r3vert/KanaType/Firmware/mockups/bold_loop_check.png

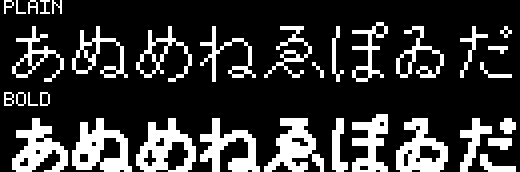
Firmware/mockups/bold_loop_check.png
