r3vert/KanaType/Firmware/mockups/drill_new.png

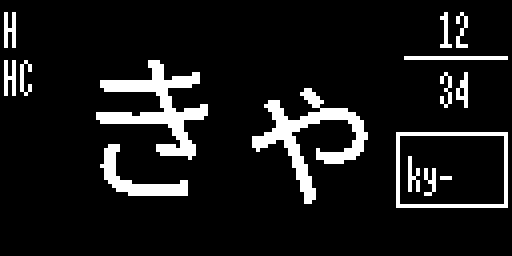
Firmware/mockups/drill_new.png
