r3vert/KanaType/Firmware/mockups/drill_real.png

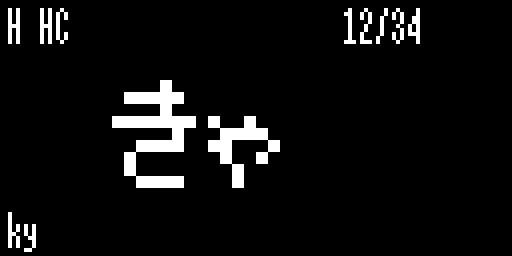
Firmware/mockups/drill_real.png
