r3vert/KanaType/Firmware/mockups/drill_reflow.png

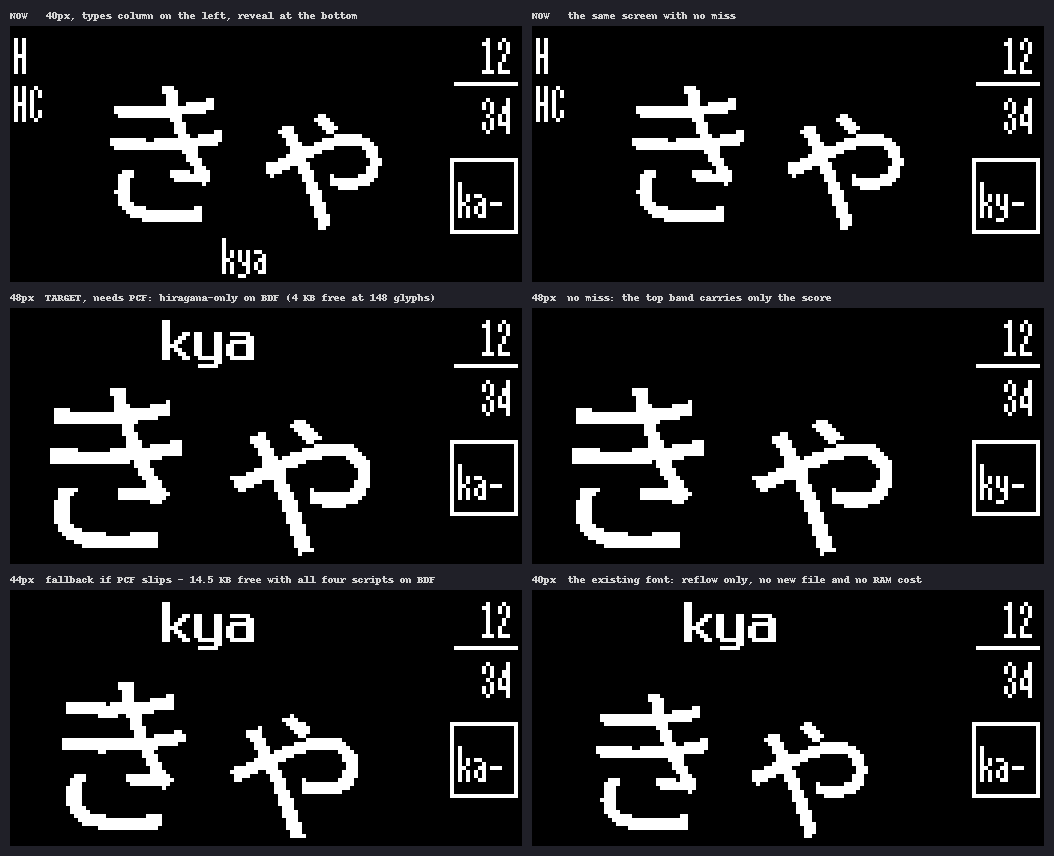
Firmware/mockups/drill_reflow.png
