r3vert/KanaType/Firmware/mockups/drill_reflow_cases.png

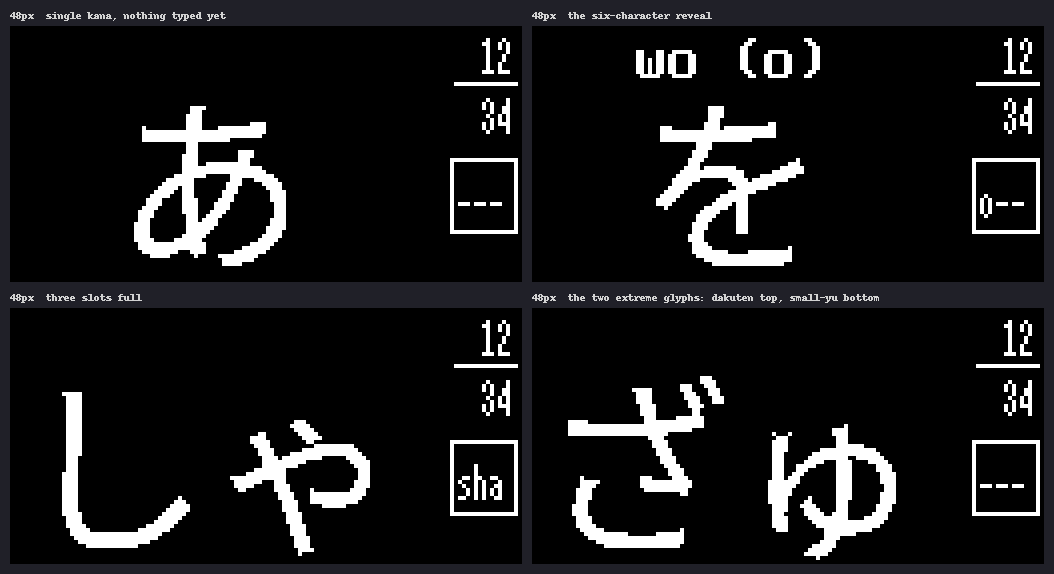
Firmware/mockups/drill_reflow_cases.png
