r3vert/KanaType/Firmware/mockups/drill_states.png

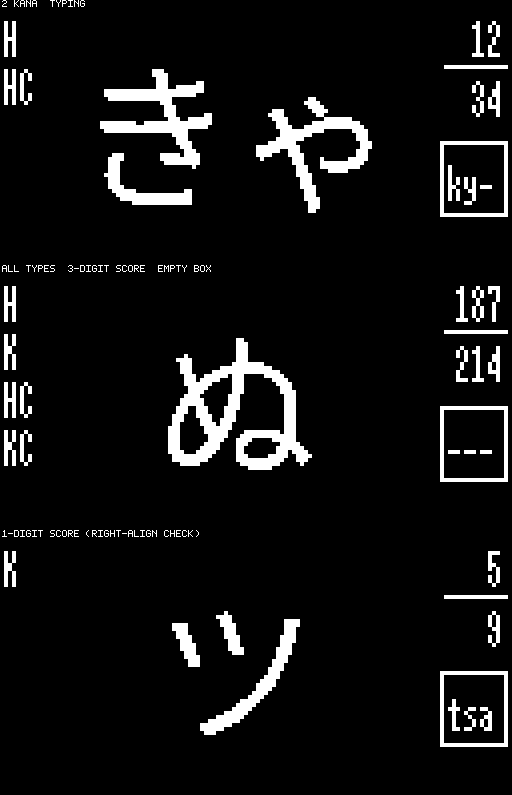
Firmware/mockups/drill_states.png
