r3vert/KanaType/Firmware/mockups/font_picker.png

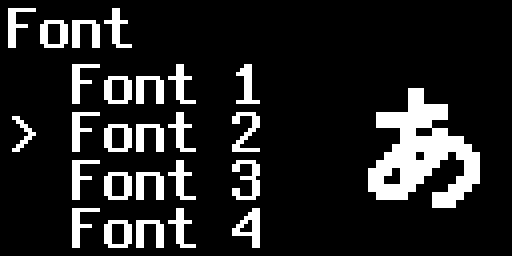
Firmware/mockups/font_picker.png
