r3vert/KanaType/Firmware/mockups/keyboard_status.png

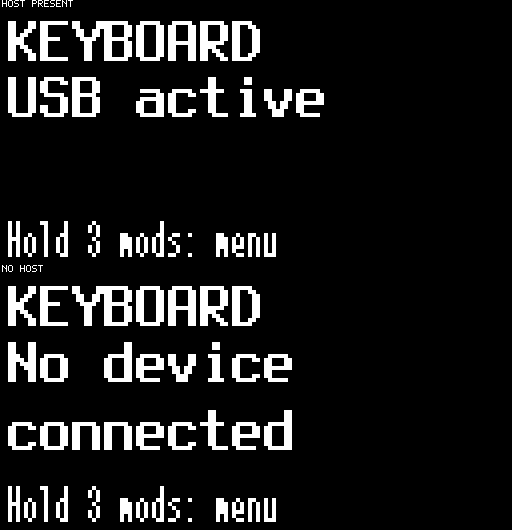
Firmware/mockups/keyboard_status.png
