r3vert/KanaType/Firmware/mockups/keymap_diagram.png

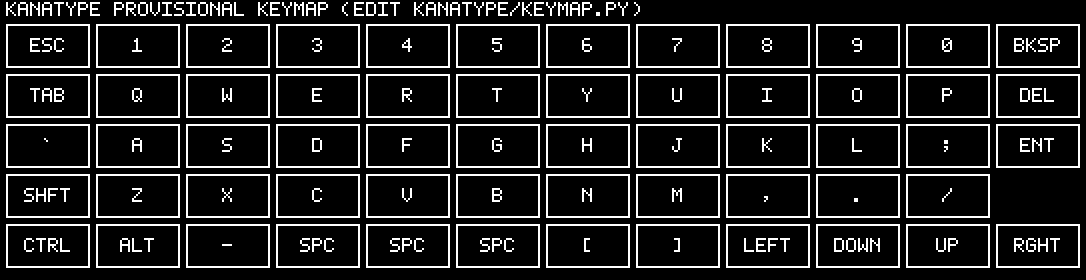
Firmware/mockups/keymap_diagram.png
