r3vert/KanaType/Firmware/mockups/loading_real.png

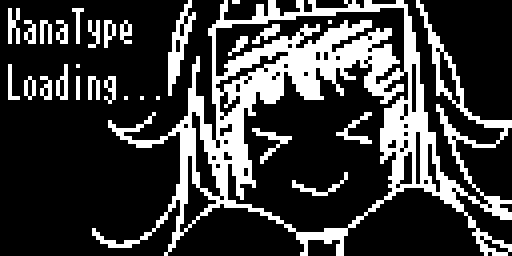
Firmware/mockups/loading_real.png
