r3vert/KanaType/Firmware/mockups/menu_16_vs_14.png

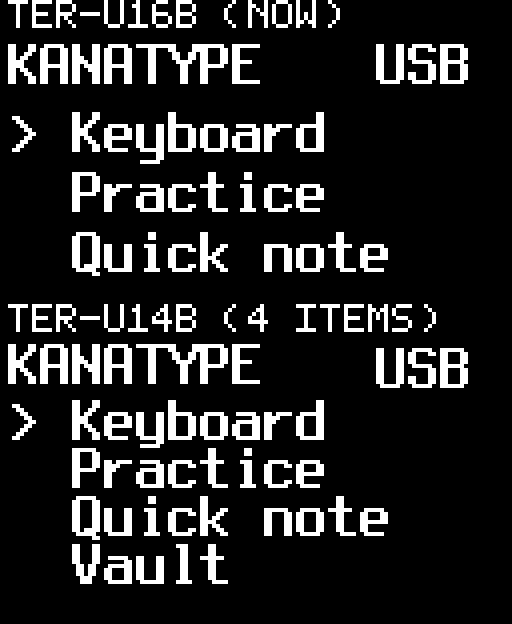
Firmware/mockups/menu_16_vs_14.png
