r3vert/KanaType/Firmware/mockups/menu_real.png

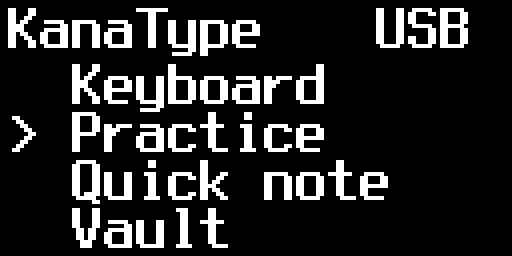
Firmware/mockups/menu_real.png
