r3vert/KanaType/Firmware/mockups/menu_terminus.png

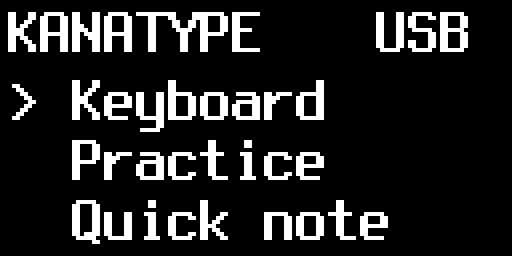
Firmware/mockups/menu_terminus.png
