r3vert/KanaType/Firmware/mockups/menu_x4.png

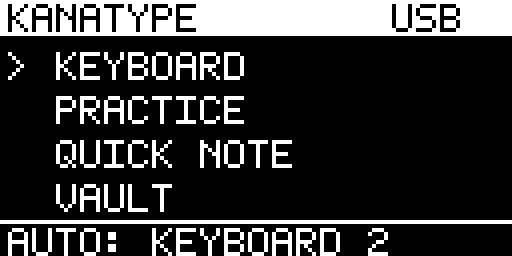
Firmware/mockups/menu_x4.png
