r3vert/KanaType/Firmware/mockups/practice_groups.png

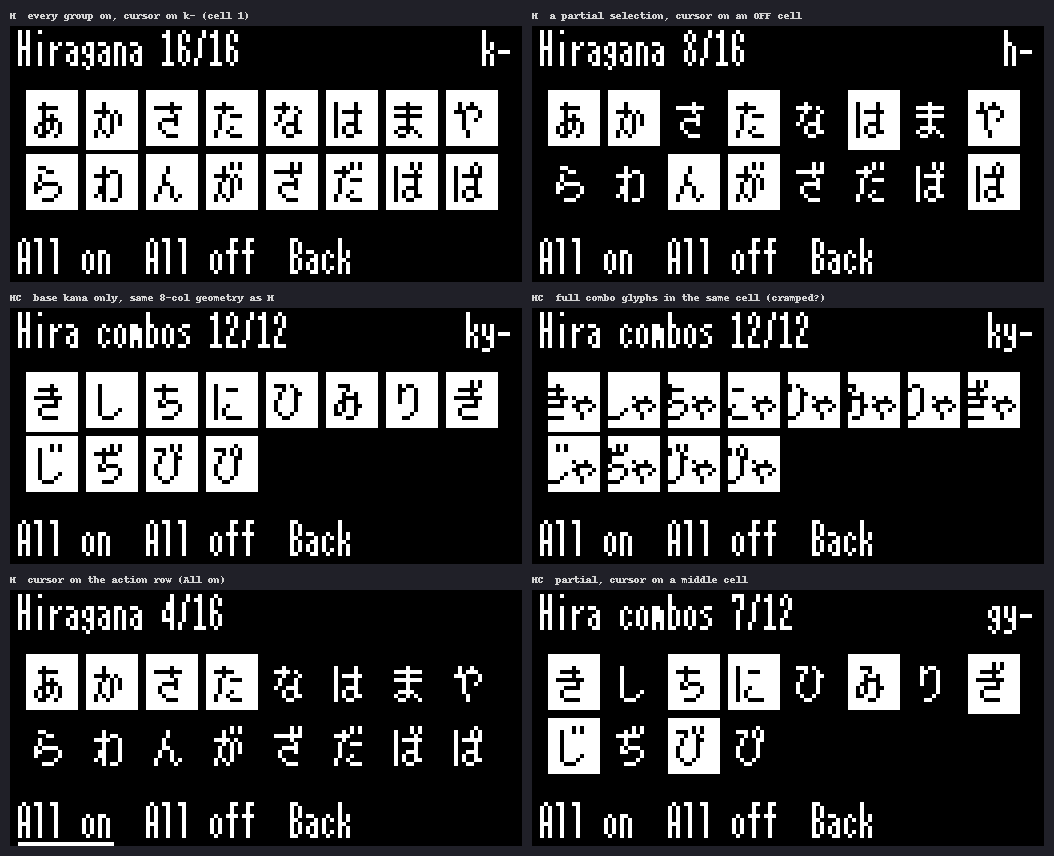
Firmware/mockups/practice_groups.png
