r3vert/KanaType/Firmware/mockups/practice_stats.png

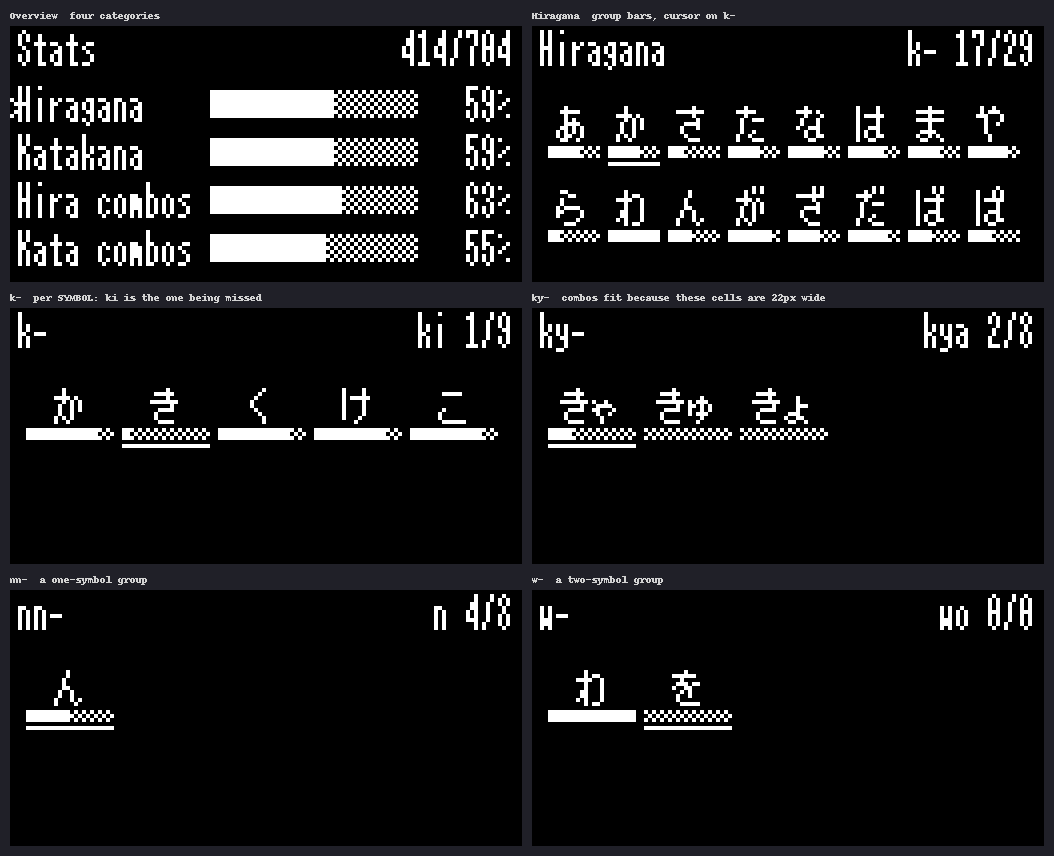
Firmware/mockups/practice_stats.png
