r3vert/KanaType/Firmware/mockups/prompt_3way.png

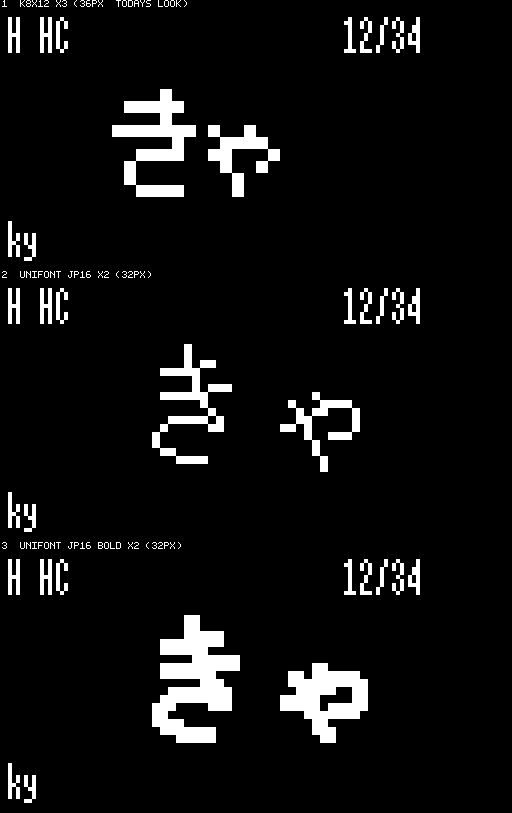
Firmware/mockups/prompt_3way.png
