r3vert/KanaType/Firmware/mockups/prompt_12_vs_16.png

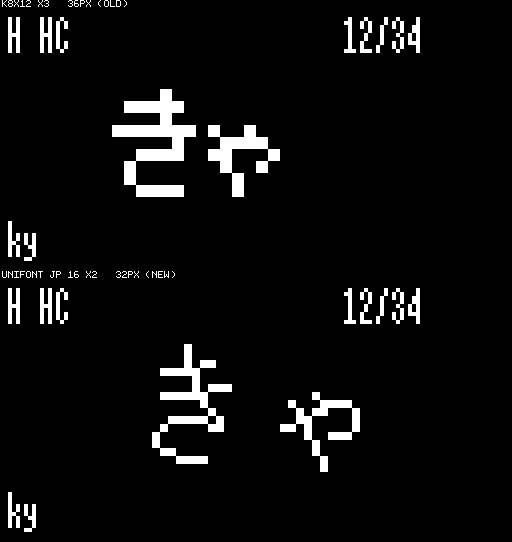
Firmware/mockups/prompt_12_vs_16.png
