r3vert/KanaType/Firmware/mockups/prompt_48_mock.png

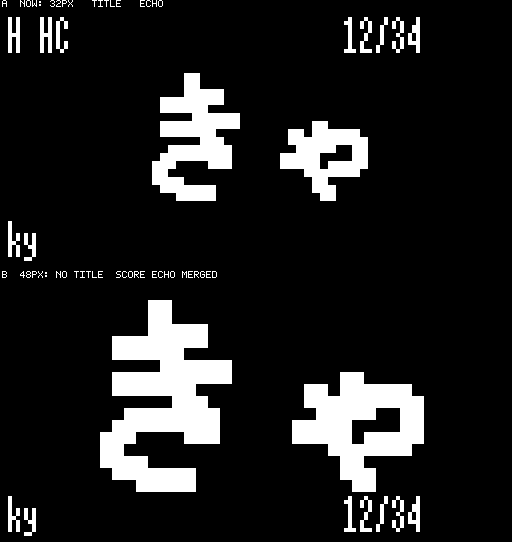
Firmware/mockups/prompt_48_mock.png
