r3vert/KanaType/Firmware/mockups/prompt_48_sources.png

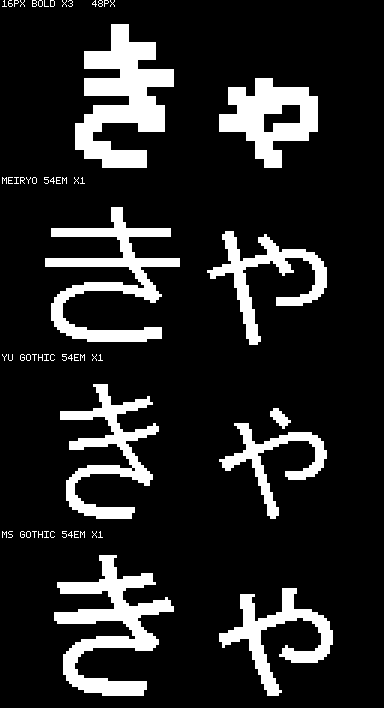
Firmware/mockups/prompt_48_sources.png
