r3vert/KanaType/Firmware/mockups/welcome (1).bmp

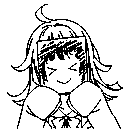
Firmware/mockups/welcome (1).bmp
