r3vert/KanaType/Firmware/mockups/welcome_BD.png

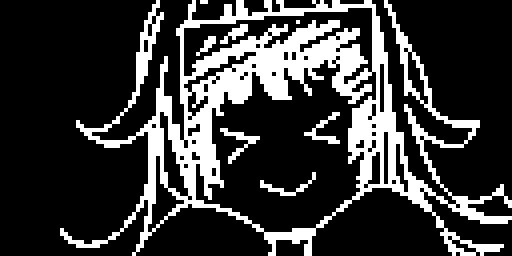
Firmware/mockups/welcome_BD.png
