r3vert/KanaType/Firmware/mockups/welcome_variants.png

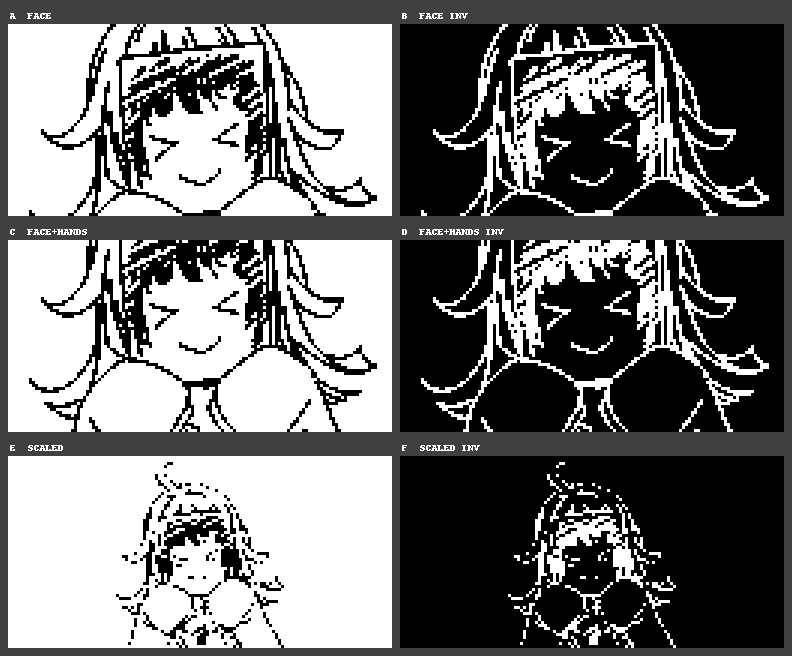
Firmware/mockups/welcome_variants.png
