r3vert/KanaType/Firmware/x.png

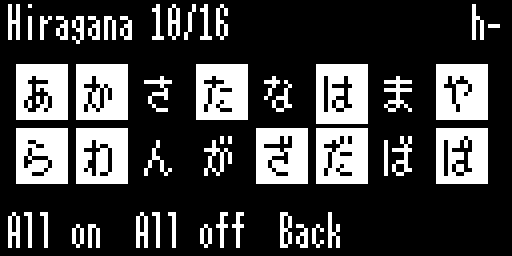
Firmware/x.png
