r3vert/KanaType/3D Printing/Bottom Case.3mf

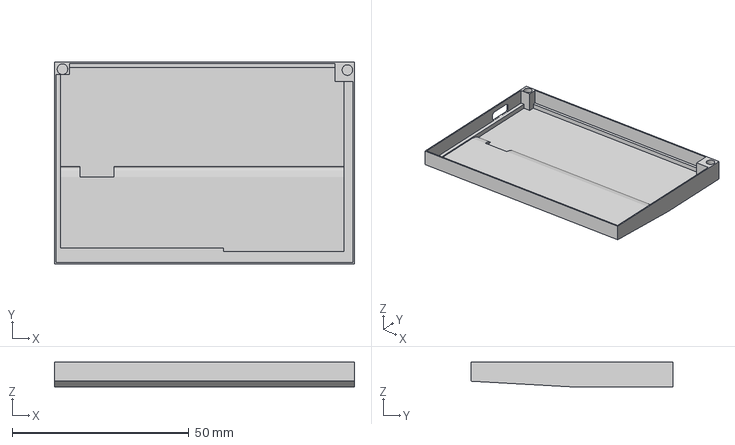
[picture p25: CAD file, 2026-08-28]
3D Printing/Bottom Case.3mf
84.8 x 57.0 x 7.00 mm
