r3vert/KanaType/3dmodels/SW-SMD_4P-L4.2-W3.2-P2.15-LS4.6.step

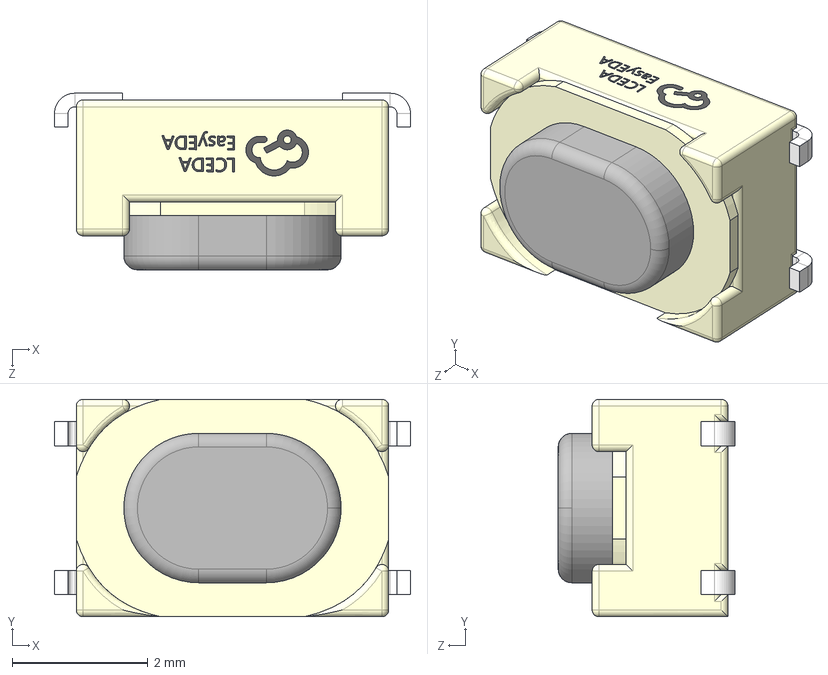
[picture p26: CAD file, 2026-07-29]
3dmodels/SW-SMD_4P-L4.2-W3.2-P2.15-LS4.6.step
5.24 x 3.20 x 2.60 mm
