r3vert/KanaType/KanaType.step

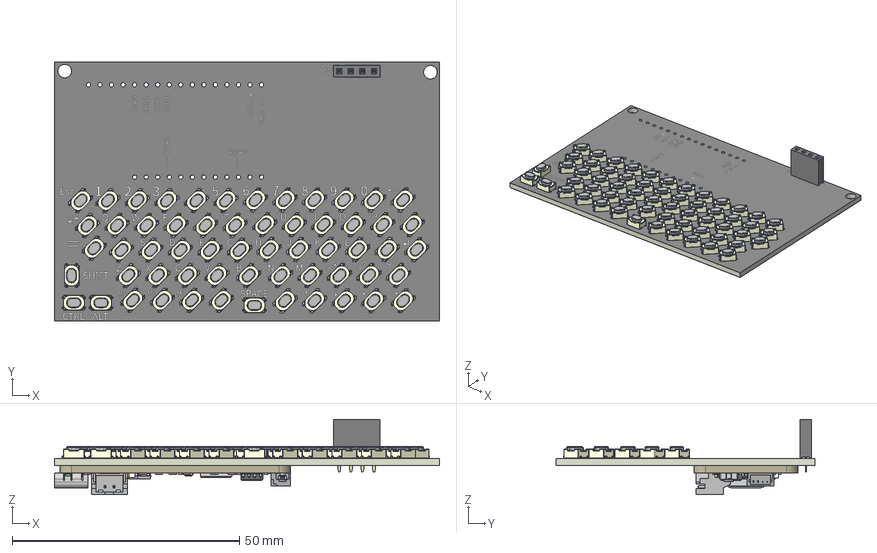
[picture p27: CAD file, 2026-08-03]
KanaType.step
84.8 x 57.0 x 16.6 mm
SW-SMD_4P-L4.2-W3.2-P2.15-LS4.6 x 59
PinSocket_1x04_P2.54mm_Vertical
Board
0805-NO x 4
CHIPLED_0603_NOOUTLINE x 2
0603-NO x 26
BTN_KMR2_4.6X2.8 x 2
SOT23-5@1
JSTPH2_BATT
SOT23-5
LED3535
SOIC8_208MIL
SOD-123
SOT23-R
USB_C_CUSB31-CFM2AX-01-X
QFN56_7MM_REDUCEDEPAD
JST_SH4
CRYSTAL_2.5X2
KanaType_silkscreen x 2
KanaType_soldermask x 2
KanaType_PCB
