r3vert/KanaType/Firmware/BRINGUP.md

# Bring-up checklist — first deploy after the 2026-08 changes

This deploy is unusually large: fonts were replaced, the practice screen was
reflowed, two apps are new, and several screens changed how they refresh. Work
top to bottom; each task says what "good" looks like and what to do if it isn't.

Tick boxes as you go. If something fails, note *what you saw* — that is what
makes it fixable.

---

## STATUS (updated live)

Last updated 2026-08-30. Clock done; the accuracy fix is confirmed on hardware.

**Committed AND pushed**: `master` is at `07276c4` on
github.com/r3vert/KanaType, ten commits, working tree clean. A pre-publish
audit removed the Windows username from 61 PCB 3D-model paths, the board UID
from `OLD/boot_out.txt`, and the 4 MB `fp-info-cache`; Terminus and Unifont
licenses were added and preflight now enforces that every `.bdf` has one.

**Tasks 1-5 and 8 are DONE on hardware.** Confirmed working: the launcher home
screen, the keyboard app with macros/profiles/second layer, and Practice
(config persistence, font picker, correction mode, relocated hint, reset to
defaults, atomic multi-kana prompts, the one-time glyph preload). RAM measured:
48 320 B free with hiragana, 24 304 B with all four scripts = 312 B per 40px
glyph, which closes PLAN open item #2.

**Tasks 6 and 7 are DONE.** WAKE brings the device back and ordinary keys do
not; the Clock sets, commits and survives leaving the app.

**Task 8 is DONE** (2026-08-30). The accuracy fix is confirmed on hardware in
both directions: set the clock and press RESET, and Clock comes back with the
frozen time flagged `approx (slept)`; sleep and wake on USB and it stays exact.
Background on why the flag never appeared in the first hardware test; two
causes, both since fixed:

* accuracy was decided when the stamp was WRITTEN, not when it was RESTORED.
  A plain RESET therefore restored a stale time and presented it as exact,
  while a USB fake-sleep (RTC still ticking, time genuinely exact) would have
  flagged it approximate. `restore_time_after_sleep()` now sets the flag,
  because a deep sleep, a RESET and a flat battery are indistinguishable from
  up there; preflight walks all four boot cases.
* **`RTC UNSET!` hides `approx`.** With the clock never set, the stamp carries
  a pre-2024 year, and `apps/clock.py` shows the unset warning in preference
  to the approximate one. Until the clock is set by hand, the flag cannot
  appear in the Clock app no matter what nvm holds -- only Home's `~` shows.

**Next action is task 9 (battery-only pass).** Also untested: the Mac handoff
(task 10).

**M2 is unblocked and PCF is in progress** -- PCF stopped being a boot-speed
nice-to-have when the drill reflow targeted a 48 px prompt (PLAN.md backlog 3).

The only thing left in task 5 is sighting `wo (o)`, which just needs that kana
to come up.

If the drive goes read-only again (it has, repeatedly), run in an **elevated**
PowerShell. `deploy.ps1` now probes writability first and prints this command
itself — before the fix it printed "Deployed" while copying nothing, because
robocopy exits 2 (not >= 8) on a write-protected target:

```powershell
Get-Volume | Where-Object FileSystemLabel -eq CIRCUITPY | Get-Partition | ForEach-Object { Set-Disk -Number $_.DiskNumber -IsReadOnly $false }
```

## 1. Delete the stale fonts  ✅ DONE

The deploy scripts are non-destructive on purpose (`robocopy /E`, `rsync`
without `--delete`) so device-side `lib/` installs are never clobbered. The
downside: fonts removed from the repo stay on the device forever.

- [x] Plug in the device, confirm CIRCUITPY mounts
- [x] Delete from `CIRCUITPY/fonts/`:
  - `k8x12.bdf` (845 KB) — replaced by `k8x12_kana.bdf`
  - `misaki_gothic.bdf` (764 KB) — role retired
  - `LICENSE-misaki.txt` (optional tidiness)
- [x] Confirm ~1.6 MB of free space came back

**Good:** `fonts/` holds only the files that are in `Firmware/src/fonts/`.

---

## 2. Preflight, then deploy  ✅ DONE

- [x] `python Firmware/tools/preflight.py` → **PREFLIGHT PASSED**
      (with the device plugged in it also flags any stale font it still finds)
- [x] `.\Firmware\tools\deploy.ps1`   (Windows)
      or `./Firmware/tools/deploy.sh`  (macOS/Linux)
- [x] Device auto-reloads

**If preflight fails:** stop. It only reports problems that have actually
broken this project before; deploying past it wastes a debugging cycle.

---

## 3. Boot and launcher  ✅ DONE (all 4 confirmed)

- [x] Panel goes straight from black to the menu — **no REPL / "Ctrl-D" text**
- [x] Title reads `KanaType`, six entries: Keyboard, Practice, Quick note,
      Vault, Clock, Sleep
- [x] Top-right shows a **tilde** briefly, then a **lightning bolt** (USB)
- [x] Arrow keys / `j`,`k` scroll the menu; it feels immediate, not laggy
- [x] Cursor starts on **Keyboard** (because USB is present)

**Then test the polling fix:**

- [x] Sit at the menu, unplug USB → icon changes to **battery** within ~1 s
- [x] Plug back in → icon returns to **bolt**, and the cursor does **not** jump

**If the icon never changes:** the poll isn't running — capture whether it was
stuck on bolt or battery.

---

## 3b. Boot timing measurement  ✅ DONE

    before:  display 180ms  input 271ms  menu 4648ms
    after:   display 180ms  input 270ms  menu  827ms
             [font 64  glyphs 595  labels 95  icons 19  paint 51]

The line reprints every 3 s while the menu is idle, since PuTTY can only attach
after boot. Toggle is `DEBUG_BOOT_TIMING` at the top of `src/code.py`; set it
`False` when you no longer want the noise. Repeats carry `(uptime Ns)`.

**Cause was not font size or `.mpy`** - the BDF loader has no glyph index, so
every uncached character rescans the whole `.bdf` from byte 0, and the menu
build did ~6 of them. `ui.preload()` now does one pass up front: 5.5x faster.
Full write-up and the per-font scan costs are in `PLAN.md`.

Boot is now ~1.3 s to an interactive menu, with the splash on screen from
180 ms, so the black screen is no longer the problem. The remaining 595 ms is
one honest pass over the BDF - see the PCF option in PLAN.md.

The same rescan hit the drill prompt at ~3.1 s per first-seen kana; `drill.py`
now preloads each font in one pass at start instead. PCF is the logged
follow-up that removes scanning altogether (PLAN.md).

## 4. Keyboard app + macro system  ✅ DONE

The whole app was rewritten on 2026-08-28 and has never run on hardware in this
form. Work it in order; the later checks assume the earlier ones passed.

### 4a. Base typing

- [x] Open Keyboard. Screen shows `KEYBOARD`, a bolt icon, `1234567890` over
      `!@#$%^&*()` on the left, `M1..M4` with assignments on the right, and
      `tap: setup` / `hold: exit` bottom-left
- [x] Type in a text editor — letters match the printed keys
- [x] `Shift`+letter capitalises; `Ctrl`+C/V copy-paste; `Alt` behaves
- [x] Spacebar (SW57, the key with the SPACE legend) types a space
- [x] Arrow keys move the caret in the right directions
- [x] **M1 types `-`** (the board's only hyphen), M2 `Ctrl+C`, M3 `Ctrl+V`,
      M4 `Ctrl+Shift+V` — M4 is the UNLABELLED key between M3 and the spacebar
- [x] The key right of the spacebar no longer types `]`

### 4b. MENU tap vs hold

- [x] Tap MENU (under Tab) → setup overlay, titled `SETUP M1-M4`
- [x] **While the overlay is open, typing does NOT reach the PC.** Watch the
      editor: every key should be swallowed. This is the `process_key`
      return-None path and it has only been verified against KMK's source
- [x] USB stays connected the whole time (no device-disconnect chime)
- [x] MENU again closes the overlay, back to the base screen
- [x] Hold MENU ~0.75 s → launcher, no console flash. **If 0.75 s feels wrong
      in the hand, say so** — `MENU_HOLD_SECONDS` in `apps/keyboard.py`

### 4c. Assigning a key

- [x] In setup, Enter on `M1` → `SET M1`, `find: _`, list of keycodes
- [x] Type `f13` → the list narrows to `F13`. **It should be instant**; a
      pause of ~1 s per letter means the ASCII preload did not work
- [x] Enter → back to the list, `M1  F13`
- [x] Close the overlay and press M1 → the PC receives F13
- [x] Assign again, this time **holding the CMD key while pressing Enter** →
      the filter line shows `+Ctrl` and the assignment reads `Ctrl+...`
- [x] Backspace on an M row clears it to `-`; that key then types nothing

### 4d. The layer toggle

- [x] Press the key right of the spacebar → the M list becomes `M5..M8`, the
      second legend row becomes `-> F1-F10`
- [x] Number row now sends **F1..F10**; **Q sends F11, W sends F12**
- [x] M5..M8 are independently assignable, and **assigning one must not change
      M1..M4** (the slot indexing is the risky part)
- [x] Press it again → back to digits and M1..M4
- [x] Press it inside the setup overlay → the title flips between
      `SETUP M1-M4` and `SETUP M5-M8`
- [x] Leave the app and come back → **starts on the base layer** (deliberate)

### 4e. Profiles and persistence

- [x] Setup → `Profile` row → Enter → profile list, `*` marks the active one
- [x] Select profile 2, assign something to M1, switch back to profile 1 →
      profile 1's assignments are intact
- [x] `Rename` → type a name (8 chars max) → Enter → the name shows in the list
- [x] **Hold MENU to the launcher, re-enter Keyboard → every assignment,
      profile and name survived** (this is the nvm round-trip)

### 4f. Host presence

- [x] Unplug USB, keep the battery on → the bolt icon becomes a battery within
      ~1 s; plug back in → bolt returns

**If a key types the wrong character:** note the physical key and what it typed.
One-line fix in `kanatype/keymap.py`, then re-run preflight.

**Expect a one-time reset:** nvm went KT05 -> KT06, so macro assignments AND
practice settings start at defaults on this deploy.

---

## 5. Practice app  ✅ DONE (except sighting `wo (o)`)

Everything below is render-verified only, so this is the section most likely to
surprise.

- [x] Open Practice → config menu appears
- [x] Toggle categories with Enter; `[x]` / `[ ]` update instantly
- [x] **Font** row opens a submenu listing the fonts BY NAME (Noto Sans,
      Unifont, Unifont B, k8x12), each previewing あ at its real drill
      size on the right — Noto Sans should look clearly the best
- [x] Pick Noto Sans, Back, then Start
- [x] **Start shows the "Loading..." splash for ~4 s**, then the drill. That is
      the one-time glyph preload (~3.1 s prompt font + ~1.2 s jp font); it
      should NOT reappear on later prompts or on re-entry in the same session
- [x] Serial prints `drill: font noto, 71 prompt glyphs, N B free` — note N,
      it answers PLAN open item #2. Enable all four scripts and check it again
      (~148 glyphs, ~46 KB more)
- [x] Drill screen: types stacked down the **left**, score as a **fraction**
      top-right, **3-slot box** below it, big kana centred
- [x] **Multi-kana prompts (きゃ etc.) appear all at once**, never one glyph
      then the other — this was the tearing fix
- [x] Type a correct answer → advances instantly, score increments
- [x] Type a wrong letter → your input stays in the box; Space/Enter advances
- [ ] A miss now prints the correct reading under the prompt; を shows
      `wo (o)` because the site teaches the pronunciation and we teach the
      typing
- [x] **Space still works here.** It used to come from four switches; M2/M3/M4
      became macro keys, so SW57 is now the ONLY key sending it, and the
      drill needs it to step past a miss
- [x] `/` reveals the reading — now on the same line a miss uses, NOT in
      the answer box, which shows only what you typed
- [x] **MENU key** (under Tab) or **Esc** → back to config; again → launcher.
      Both send app code `exit`; there is no exit combo any more

**Persistence:**

- [x] Change categories/mode/font, exit to the menu, re-enter Practice →
      **your settings are still there**
- [x] "Reset to defaults" → Hiragana only, Instant, Bypass, Noto Sans,
      status says `Defaults restored`

---

## 6. Clock  ✅ DONE

- [x] Open Clock → live date/time, seconds ticking
- [x] Expect **`RTC UNSET!`** on a cold boot (year reads pre-2024)
- [x] Enter → edit mode, dashes underline the active field
- [x] LEFT/RIGHT move between year/month/day/hour/minute; UP/DOWN change values
- [x] Enter commits → warning clears, seconds tick from :00
- [x] Leave and re-enter Clock → time still correct

---

## 7. Sleep + wake  ✅ DONE

- [x] From the menu, choose **Sleep** → "WAKE button wakes me up", screen off
- [x] Press any *ordinary* key → **nothing happens** (this is intended)
- [x] Press **WAKE** → device wakes and returns to the menu

**Note:** while USB is connected CircuitPython refuses true deep sleep, so this
is screen-off only. For the real power test, run it on battery, unplugged.

---

## 8. RTC across deep sleep  ✅ DONE — it does NOT survive, and the carry-over works

Tested 2026-08-28: set the clock, Sleep, WAKE — the RTC came back unset.

This is structural, not a bug. CircuitPython's deep sleep cuts power to nearly
all of the RP2040 and restarts `code.py` from the top, and the Feather RP2040
has no battery-backed RTC domain: the LiPo holds the rail up, but the RTC's
clock stops and the chip resets on wake. No firmware change recovers the real
time.

**What shipped instead** (untested on hardware — verify below):

* `sleepmode.py` stamps the wall clock into nvm before sleeping
* `code.py` restores it on boot, but only if the RTC looks unset — on USB,
  CircuitPython does a *fake* deep sleep that keeps the RTC ticking, and the
  stamp would be the older value
* the time is flagged **approximate** at RESTORE time, because how long the
  device was off is unknowable -- and a RESET or a flat battery is just as
  unknowable as a sleep, so all three flag it. Clock shows `approx (slept)`
  until you set it by hand. Flagging it at SAVE time instead was the
  2026-08-29 bug: it made a reset lie and a USB fake-sleep cry wolf.
* the stamp lives after the MAGIC-guarded blob under its own marker byte, so
  this did NOT reset macros or practice settings

**Do task 6 first.** With the clock unset, `RTC UNSET!` is shown in place of
`approx (slept)`, so none of this is observable in the Clock app.

- [x] Set the clock by hand → hint reads `Enter: set`, and Home shows no `~`
- [x] **Press RESET, no sleep involved** → Clock reads the time you set,
      frozen (not now), and the hint reads **`approx (slept)`**. This is the
      case that used to present a stale clock as exact
- [x] **Unplug USB**, Sleep, wait a known interval, WAKE, open Clock
- [x] Date and time are roughly right (they will be the time you went to
      sleep, NOT now) and the hint reads **`approx (slept)`**
- [x] Set the time by hand again → `approx` disappears at once. It comes
      **back** on the next power-cycle, and that is correct: the clock really
      is stale again by however long the device was off
- [x] Plugged into USB: Sleep → WAKE → the clock should be **still correct
      and NOT flagged approx**, because a fake deep sleep keeps it running

**If it comes back unset even with a stamp stored:** the restore is not
running. `power.restore_time_after_sleep()` is called from `code.py` right
after input init; check the serial console for an exception.

Two ways to make the clock genuinely right, both in PLAN.md open item #3 and
neither built: a periodic `TimeAlarm` re-stamp (cheap in power, needs a
boot-time "went back to sleep" path), or an external DS3231/PCF8523 with its
own coin cell on the existing I2C bus (proper fix, needs a v2 board).

---

## 9. Battery-only pass  <-- NEXT ACTION

- [ ] Unplug and power from the LiPo alone
- [ ] Boot → menu shows the **battery** icon, cursor starts on **Quick note**
- [ ] Practice still runs on battery
- [ ] Keyboard app shows `No device connected`

---

## 9b. PCF fonts  — PART-CONFIRMED (2026-08-30)

The device loads PCF instead of BDF, and the drill no longer preloads its
prompt font. Confirmed on hardware:

- [x] Menu, Practice config and the drill all render — a wrong bit order would
      have scrambled every glyph, so this settles the one thing that could not
      be checked offline (`bitmaptools.readinto` uses `element_size=4`, not the
      pure-Python path the desktop verifier replicates)
- [x] Kana render correctly in the drill
- [x] **Practice enters instantly, with no "Loading..." splash** — that splash
      only ever existed to cover the multi-second glyph preload

MEASURED:

- [x] **`glyphs` 595 ms -> 128 ms (4.6x)**, menu build 827 -> 563 ms:

          PCF:  display 181ms  input 296ms  menu 563ms
                [font 90  glyphs 128  labels 245  paint 40]

      Only `glyphs` compares directly against the old line -- the home screen
      was redesigned in between, so `labels` now builds a clock too. PLAN.md
      has the full reading.
- [x] `drill: font noto, deck can show 15 kana, 58480 B free` — 15 distinct
      glyphs means an HC-only deck: combos reuse their base kana, so 36
      prompts need only 11 bases plus small ya/yu/yo

Still open, and it needs a BIG deck to show anything:

- [ ] **The glyph-cache curve with all four scripts on** (148 distinct glyphs).
      `DEBUG_RAM` in `drill.py` prints every 10 answers:

          drill: N answered, C/148 prompt glyphs, M B free

      Watch **C**, not M: it should climb toward 148 and stop, and where the
      free figure settles at that point is the eviction floor a 48 px prompt
      needs (PLAN.md backlog 3). An HC-only deck tops out at 15 glyphs and
      proves nothing.

      **The first attempt at this measurement was invalid** and is worth not
      repeating: the trace called `gc.mem_free()` without `gc.collect()` first,
      so it reported free heap including uncollected garbage. Over 60 answers
      it printed 46/57/59/52/55/50 KB — a sawtooth that rises as often as it
      falls, because it was showing the allocator rather than the glyph cache.
      Now it collects first and prints the resident glyph COUNT, which needs
      no inference at all.
- [ ] A multi-kana prompt (きゃ) still appears as ONE unit, never one glyph
      then the other

**660 KB of superseded .bdf stay on the device deliberately** as a rollback:
flip `layout.FONT_PATHS` back to `.bdf` and the fonts are already there.
preflight warns rather than fails while they are there. Delete with
`rm P:/fonts/*.bdf` once PCF is signed off.

---

## 9c. Practice: per-group toggles + stats  ✅ DONE (2026-08-30)

Both were parked features; the user asked for them and both are confirmed on
hardware the same day.

**Per-group toggles:**

- [x] RIGHT on a category row opens its grid; tap Enter toggles the whole
      category
- [x] Enabled cells invert, cursor underlines, romaji tracks the cursor
- [x] All on / All off / Back; Start refuses an all-off selection
- [x] Selections survive leaving Practice, and macros/clock are untouched
      (separate nvm region at [113:122])

**Stats** (LAYER, right of the spacebar — NOT MENU, which is `exit`):

- [x] Overview: a dithered bar per category, "-" where nothing was answered
- [x] Enter → group grid, Enter again → SYMBOL grid
- [x] No flash between screens (each screen swaps itself in; `run()` restores
      the drill once, at the end)
- [x] LAYER returns to the drill from any level, prompt and score intact

Still open, and it is a decision rather than a bug:

- [ ] **Per-session or lifetime stats.** Per-session today. Lifetime needs
      ~224 bytes of nvm (56 groups x 4) and a reset affordance.
- [ ] **Capture `nvm NB` from the boot line.** Never recorded, and it decides
      whether lifetime stats have room at all.

---

## 10. Wrap up

- [ ] Note anything that looked wrong, with the screen and the key involved
- [x] `git add -A && git commit` — done, and pushed to origin/master
- [ ] If moving to the Mac: push, clone there, `chmod +x Firmware/tools/deploy.sh`

---

## Optional cleanups (no functional effect)

- `ter-u14b.bdf` (169 KB, kept only as the subset source) and `ter-u16b.bdf`
  (177 KB, unused spare) sit on the device doing nothing at runtime: 346 KB of
  flash. Both are one-file downloads to restore. Boot time is unaffected.
- A stale `__pycache__/` folder from an earlier compile pass is on the device.
  Harmless; CircuitPython ignores it.

## Known-incomplete (not bugs)

- **Quick note** and **Vault** are still stubs ("Not built yet") — M2 work.
- **Nothing renders kanji any more.** The vault reader will need a
  kanji-capable font regenerated first (recipes in `src/fonts/README.md`).
- **Practice settings reset once** on this deploy — the nvm format version
  changed, so the old blob is deliberately rejected rather than misread.
