r3vert/KanaType/KanaType.kicad_pcb

## KiCad design KanaType.kicad_pcb (2026-08-29)

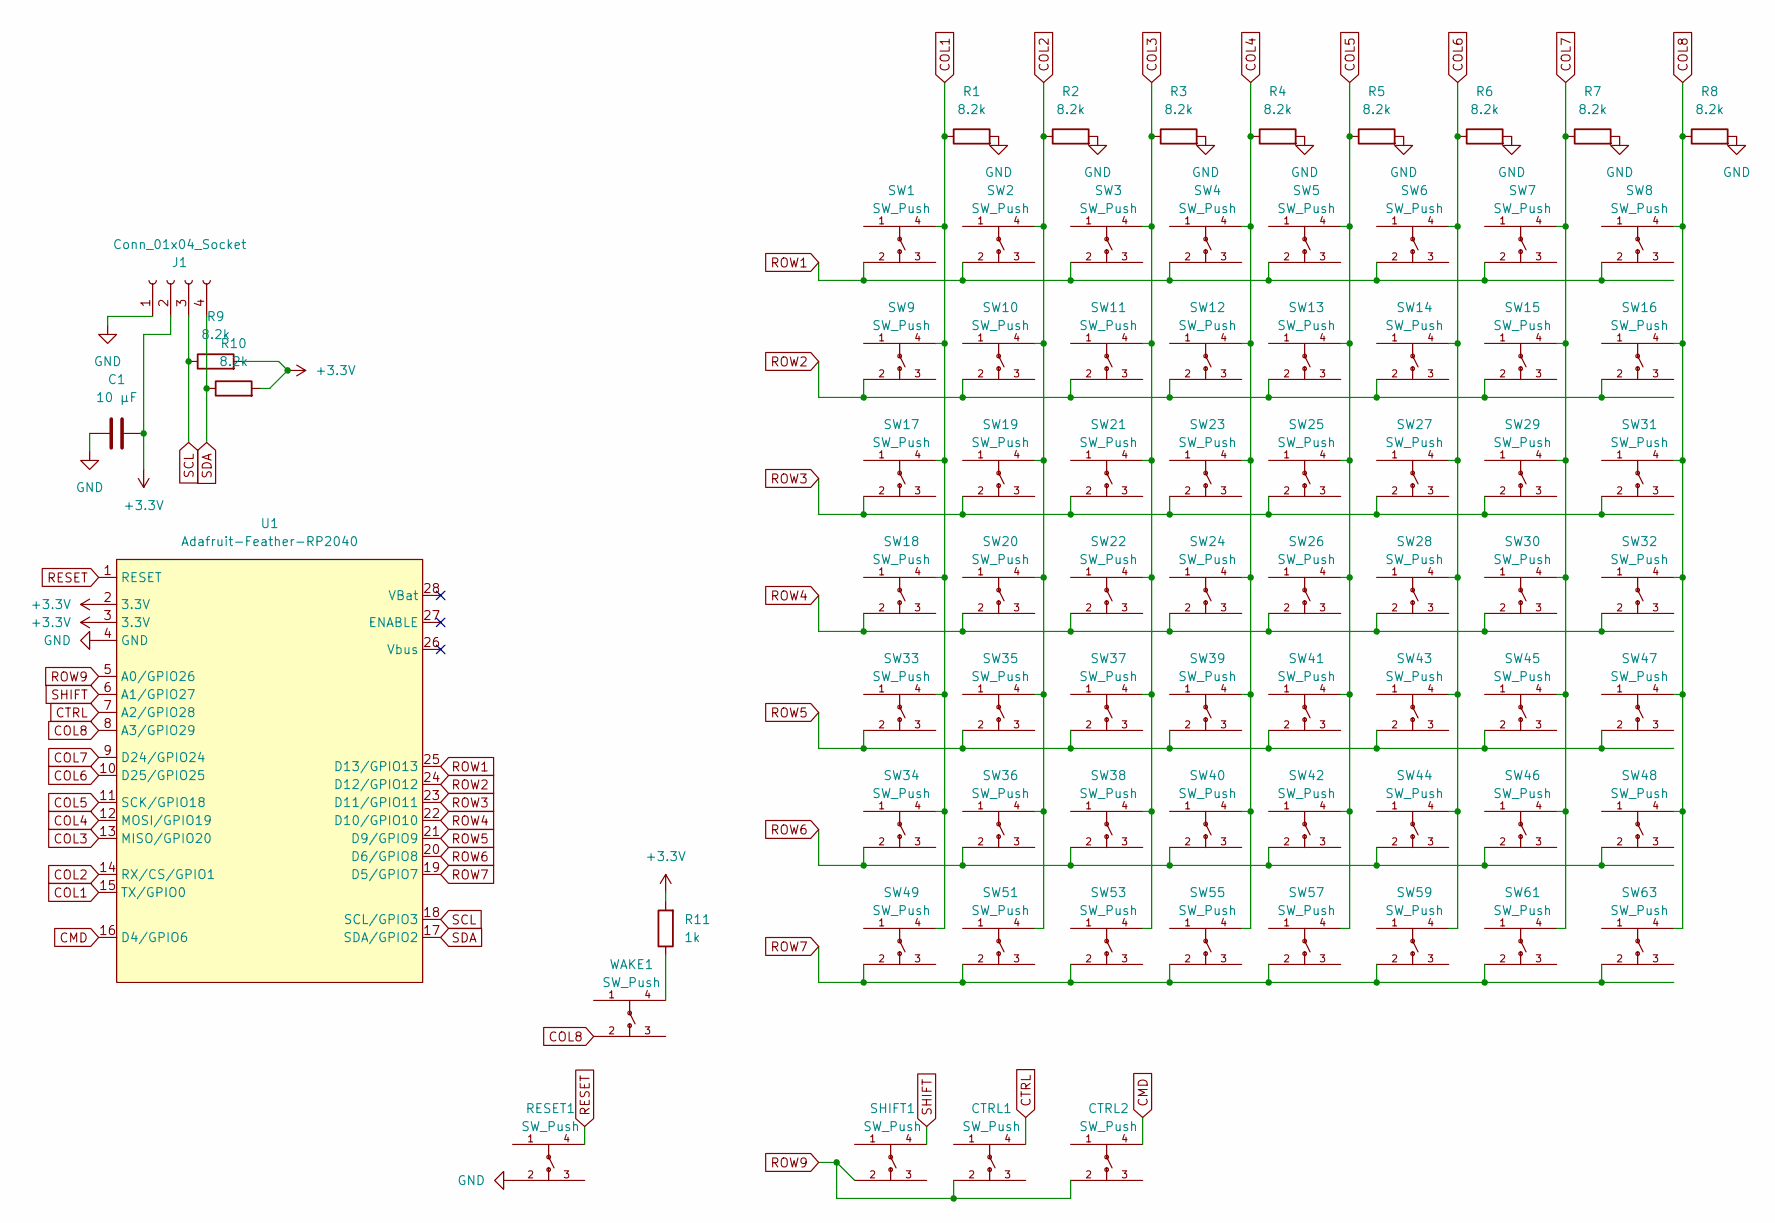
[picture p28: schematic KanaType.kicad_sch]

Parts:
C1: 10 μF; C_0805_2012Metric_Pad1.18x1.45mm_HandSolder
CTRL1, CTRL2: SW_Push; SW-SMD_4P-L4.2-W3.2-P2.15-LS4.6; LCSC C2910644
J1: Conn_01x04_Socket; PinSocket_1x04_P2.54mm_Vertical
R1, R2, R3, R4, R5, R6, R7, R8, R9, R10: 8.2k; R_0805_2012Metric_Pad1.20x1.40mm_HandSolder
R11: 1k; R_0805_2012Metric_Pad1.20x1.40mm_HandSolder
RESET1: SW_Push; SW-SMD_4P-L4.2-W3.2-P2.15-LS4.6; LCSC C2910644
SHIFT1: SW_Push; SW-SMD_4P-L4.2-W3.2-P2.15-LS4.6; LCSC C2910644
SW1, SW2, SW3, SW4, SW5, SW6, SW7, SW8, SW9, SW10, SW11, SW12, SW13, SW14, SW15, SW16, SW17, SW18, SW19, SW20, SW21, SW22, SW23, SW24, SW25, SW26, SW27, SW28, SW29, SW30, SW31, SW32, SW33, SW34, SW35, SW36, SW37, SW38, SW39, SW40, SW41, SW42, SW43, SW44, SW45, SW46, SW47, SW48, SW49, SW51, SW53, SW55, SW57, SW59, SW61, SW63: SW_Push; SW-SMD_4P-L4.2-W3.2-P2.15-LS4.6; LCSC C2910644
U1: Adafruit-Feather-RP2040; Adafruit_Feather
WAKE1: SW_Push; SW-SMD_4P-L4.2-W3.2-P2.15-LS4.6; LCSC C2910644

Connections:
+3.3V: C1.2, J1.2, R9.2, R10.2, R11.2, U1.2 (3.3V), U1.3 (3.3V)
CMD: CTRL2.4, U1.16 (D4/GPIO6)
COL1: R1.1, SW1.4, SW9.4, SW17.4, SW18.4, SW33.4, SW34.4, SW49.4, U1.15 (TX/GPIO0)
COL2: R2.1, SW2.4, SW10.4, SW19.4, SW20.4, SW35.4, SW36.4, SW51.4, U1.14 (RX/CS/GPIO1)
COL3: R3.1, SW3.4, SW11.4, SW21.4, SW22.4, SW37.4, SW38.4, SW53.4, U1.13 (MISO/GPIO20)
COL4: R4.1, SW4.4, SW12.4, SW23.4, SW24.4, SW39.4, SW40.4, SW55.4, U1.12 (MOSI/GPIO19)
COL5: R5.1, SW5.4, SW13.4, SW25.4, SW26.4, SW41.4, SW42.4, SW57.4, U1.11 (SCK/GPIO18)
COL6: R6.1, SW6.4, SW14.4, SW27.4, SW28.4, SW43.4, SW44.4, SW59.4, U1.10 (D25/GPIO25)
COL7: R7.1, SW7.4, SW15.4, SW29.4, SW30.4, SW45.4, SW46.4, SW61.4, U1.9 (D24/GPIO24)
COL8: R8.1, SW8.4, SW16.4, SW31.4, SW32.4, SW47.4, SW48.4, SW63.4, U1.8 (A3/GPIO29), WAKE1.2
CTRL: CTRL1.4, U1.7 (A2/GPIO28)
GND: C1.1, J1.1, R1.2, R2.2, R3.2, R4.2, R5.2, R6.2, R7.2, R8.2, RESET1.2, U1.4 (GND)
unnamed: R11.1, WAKE1.4
RESET: RESET1.4, U1.1 (RESET)
ROW1: SW1.2, SW2.2, SW3.2, SW4.2, SW5.2, SW6.2, SW7.2, SW8.2, U1.25 (D13/GPIO13)
ROW2: SW9.2, SW10.2, SW11.2, SW12.2, SW13.2, SW14.2, SW15.2, SW16.2, U1.24 (D12/GPIO12)
ROW3: SW17.2, SW19.2, SW21.2, SW23.2, SW25.2, SW27.2, SW29.2, SW31.2, U1.23 (D11/GPIO11)
ROW4: SW18.2, SW20.2, SW22.2, SW24.2, SW26.2, SW28.2, SW30.2, SW32.2, U1.22 (D10/GPIO10)
ROW5: SW33.2, SW35.2, SW37.2, SW39.2, SW41.2, SW43.2, SW45.2, SW47.2, U1.21 (D9/GPIO9)
ROW6: SW34.2, SW36.2, SW38.2, SW40.2, SW42.2, SW44.2, SW46.2, SW48.2, U1.20 (D6/GPIO8)
ROW7: SW49.2, SW51.2, SW53.2, SW55.2, SW57.2, SW59.2, SW61.2, SW63.2, U1.19 (D5/GPIO7)
ROW9: CTRL1.2, CTRL2.2, SHIFT1.2, U1.5 (A0/GPIO26)
SCL: J1.3, R9.1, U1.18 (SCL/GPIO3)
SDA: J1.4, R10.1, U1.17 (SDA/GPIO2)
SHIFT: SHIFT1.4, U1.6 (A1/GPIO27)

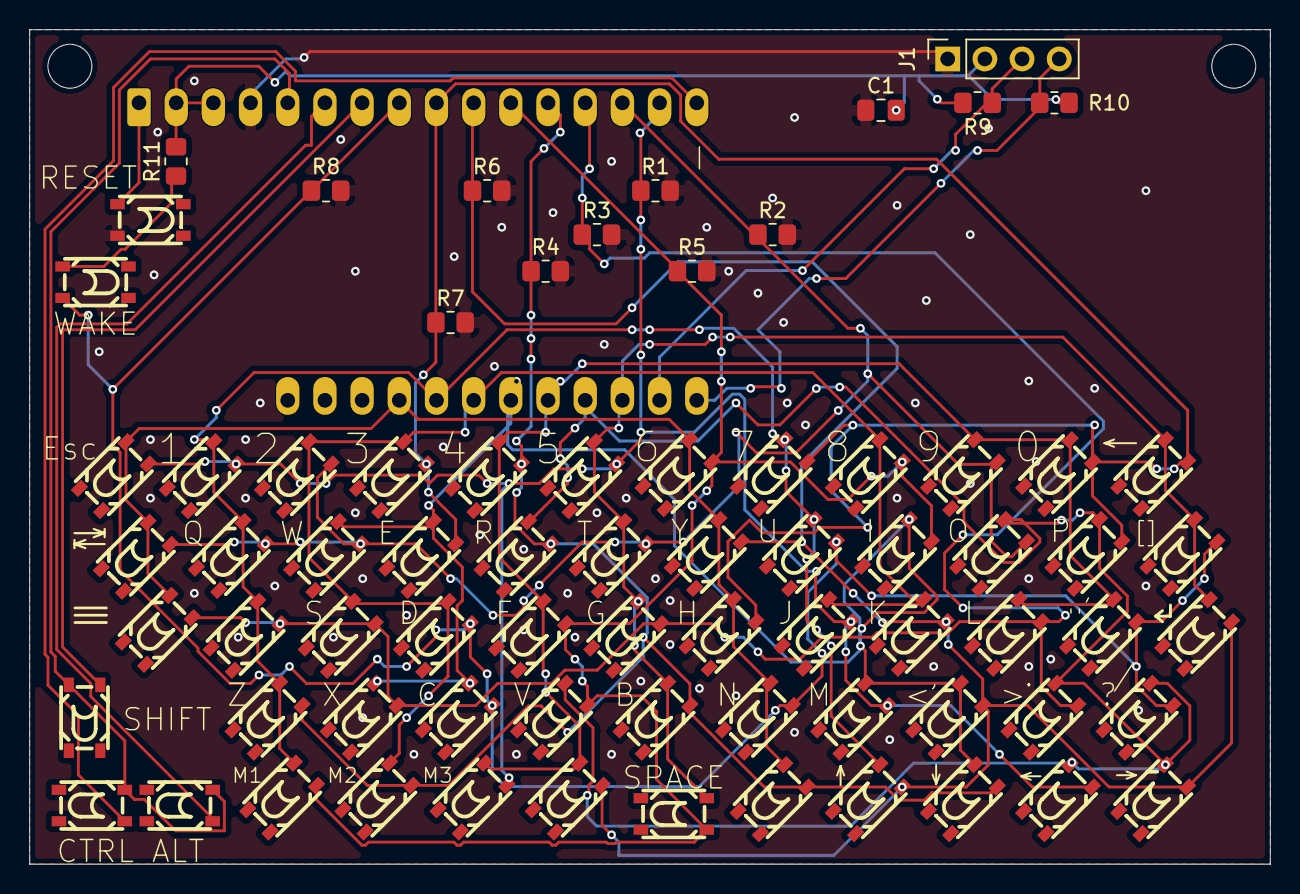
[picture p29: board KanaType.kicad_pcb from above]

Board: 2 copper layers, 84.8 x 57.0 mm, 75 parts (1 on the bottom side), 25 nets.
