r3vert/KanaType/Firmware/src/kanatype/kana.py

"""Kana data — single source of truth for the practice decks.

Row granularity mirrors DJT Kana: basic rows, dakuten rows, digraph combos,
each in hiragana and katakana. Categories: H (hira incl. dakuten),
HC (hira combos), K, KC.

PROVENANCE: the romaji here were typed by hand, not imported. Two independent
checks guard them, both in tools/preflight.py or run against it:

1. Hepburn is DERIVED from the rules (consonant x vowel, the irregulars
   shi/chi/tsu/fu/ji/zu, the digraph forms) and compared entry by entry.
   All 214 match. This runs on every preflight.
2. Cross-checked 2026-08-28 against DJT Kana's own chart, extracted from a
   saved copy of the page: identical 214-kana inventory, and 212 of 214
   readings identical.

The two deliberate differences are WO below.
"""

SAMPLE = "あいう アイウ"

# --- rows: (category, row_id, [(kana, canonical_romaji), ...]) --------------
ROWS = [
    ("H", "a", [("あ", "a"), ("い", "i"), ("う", "u"), ("え", "e"), ("お", "o")]),
    ("H", "k", [("か", "ka"), ("き", "ki"), ("く", "ku"), ("け", "ke"), ("こ", "ko")]),
    ("H", "s", [("さ", "sa"), ("し", "shi"), ("す", "su"), ("せ", "se"), ("そ", "so")]),
    ("H", "t", [("た", "ta"), ("ち", "chi"), ("つ", "tsu"), ("て", "te"), ("と", "to")]),
    ("H", "n", [("な", "na"), ("に", "ni"), ("ぬ", "nu"), ("ね", "ne"), ("の", "no")]),
    ("H", "h", [("は", "ha"), ("ひ", "hi"), ("ふ", "fu"), ("へ", "he"), ("ほ", "ho")]),
    ("H", "m", [("ま", "ma"), ("み", "mi"), ("む", "mu"), ("め", "me"), ("も", "mo")]),
    ("H", "y", [("や", "ya"), ("ゆ", "yu"), ("よ", "yo")]),
    ("H", "r", [("ら", "ra"), ("り", "ri"), ("る", "ru"), ("れ", "re"), ("ろ", "ro")]),
    # WO: DJT Kana shows "o" (how the particle is PRONOUNCED). We keep "wo"
    # because this is a typing trainer and "wo" is what you press to produce
    # it; "o" is accepted too, via VARIANTS.
    ("H", "w", [("わ", "wa"), ("を", "wo")]),
    ("H", "nn", [("ん", "n")]),
    ("H", "g", [("が", "ga"), ("ぎ", "gi"), ("ぐ", "gu"), ("げ", "ge"), ("ご", "go")]),
    ("H", "z", [("ざ", "za"), ("じ", "ji"), ("ず", "zu"), ("ぜ", "ze"), ("ぞ", "zo")]),
    ("H", "d", [("だ", "da"), ("ぢ", "ji"), ("づ", "zu"), ("で", "de"), ("ど", "do")]),
    ("H", "b", [("ば", "ba"), ("び", "bi"), ("ぶ", "bu"), ("べ", "be"), ("ぼ", "bo")]),
    ("H", "p", [("ぱ", "pa"), ("ぴ", "pi"), ("ぷ", "pu"), ("ぺ", "pe"), ("ぽ", "po")]),
    ("HC", "ky", [("きゃ", "kya"), ("きゅ", "kyu"), ("きょ", "kyo")]),
    ("HC", "sh", [("しゃ", "sha"), ("しゅ", "shu"), ("しょ", "sho")]),
    ("HC", "ch", [("ちゃ", "cha"), ("ちゅ", "chu"), ("ちょ", "cho")]),
    ("HC", "ny", [("にゃ", "nya"), ("にゅ", "nyu"), ("にょ", "nyo")]),
    ("HC", "hy", [("ひゃ", "hya"), ("ひゅ", "hyu"), ("ひょ", "hyo")]),
    ("HC", "my", [("みゃ", "mya"), ("みゅ", "myu"), ("みょ", "myo")]),
    ("HC", "ry", [("りゃ", "rya"), ("りゅ", "ryu"), ("りょ", "ryo")]),
    ("HC", "gy", [("ぎゃ", "gya"), ("ぎゅ", "gyu"), ("ぎょ", "gyo")]),
    ("HC", "j", [("じゃ", "ja"), ("じゅ", "ju"), ("じょ", "jo")]),
    ("HC", "dj", [("ぢゃ", "ja"), ("ぢゅ", "ju"), ("ぢょ", "jo")]),
    ("HC", "by", [("びゃ", "bya"), ("びゅ", "byu"), ("びょ", "byo")]),
    ("HC", "py", [("ぴゃ", "pya"), ("ぴゅ", "pyu"), ("ぴょ", "pyo")]),
    ("K", "a", [("ア", "a"), ("イ", "i"), ("ウ", "u"), ("エ", "e"), ("オ", "o")]),
    ("K", "k", [("カ", "ka"), ("キ", "ki"), ("ク", "ku"), ("ケ", "ke"), ("コ", "ko")]),
    ("K", "s", [("サ", "sa"), ("シ", "shi"), ("ス", "su"), ("セ", "se"), ("ソ", "so")]),
    ("K", "t", [("タ", "ta"), ("チ", "chi"), ("ツ", "tsu"), ("テ", "te"), ("ト", "to")]),
    ("K", "n", [("ナ", "na"), ("ニ", "ni"), ("ヌ", "nu"), ("ネ", "ne"), ("ノ", "no")]),
    ("K", "h", [("ハ", "ha"), ("ヒ", "hi"), ("フ", "fu"), ("ヘ", "he"), ("ホ", "ho")]),
    ("K", "m", [("マ", "ma"), ("ミ", "mi"), ("ム", "mu"), ("メ", "me"), ("モ", "mo")]),
    ("K", "y", [("ヤ", "ya"), ("ユ", "yu"), ("ヨ", "yo")]),
    ("K", "r", [("ラ", "ra"), ("リ", "ri"), ("ル", "ru"), ("レ", "re"), ("ロ", "ro")]),
    ("K", "w", [("ワ", "wa"), ("ヲ", "wo")]),
    ("K", "nn", [("ン", "n")]),
    ("K", "g", [("ガ", "ga"), ("ギ", "gi"), ("グ", "gu"), ("ゲ", "ge"), ("ゴ", "go")]),
    ("K", "z", [("ザ", "za"), ("ジ", "ji"), ("ズ", "zu"), ("ゼ", "ze"), ("ゾ", "zo")]),
    ("K", "d", [("ダ", "da"), ("ヂ", "ji"), ("ヅ", "zu"), ("デ", "de"), ("ド", "do")]),
    ("K", "b", [("バ", "ba"), ("ビ", "bi"), ("ブ", "bu"), ("ベ", "be"), ("ボ", "bo")]),
    ("K", "p", [("パ", "pa"), ("ピ", "pi"), ("プ", "pu"), ("ペ", "pe"), ("ポ", "po")]),
    ("KC", "ky", [("キャ", "kya"), ("キュ", "kyu"), ("キョ", "kyo")]),
    ("KC", "sh", [("シャ", "sha"), ("シュ", "shu"), ("ショ", "sho")]),
    ("KC", "ch", [("チャ", "cha"), ("チュ", "chu"), ("チョ", "cho")]),
    ("KC", "ny", [("ニャ", "nya"), ("ニュ", "nyu"), ("ニョ", "nyo")]),
    ("KC", "hy", [("ヒャ", "hya"), ("ヒュ", "hyu"), ("ヒョ", "hyo")]),
    ("KC", "my", [("ミャ", "mya"), ("ミュ", "myu"), ("ミョ", "myo")]),
    ("KC", "ry", [("リャ", "rya"), ("リュ", "ryu"), ("リョ", "ryo")]),
    ("KC", "gy", [("ギャ", "gya"), ("ギュ", "gyu"), ("ギョ", "gyo")]),
    ("KC", "j", [("ジャ", "ja"), ("ジュ", "ju"), ("ジョ", "jo")]),
    ("KC", "dj", [("ヂャ", "ja"), ("ヂュ", "ju"), ("ヂョ", "jo")]),
    ("KC", "by", [("ビャ", "bya"), ("ビュ", "byu"), ("ビョ", "byo")]),
    ("KC", "py", [("ピャ", "pya"), ("ピュ", "pyu"), ("ピョ", "pyo")]),
]

# Accepted alternative romanizations (DJT 'replacements' equivalent; global,
# so e.g. 'di' is accepted for either ji-kana — same leniency as the site).
VARIANTS = {
    "shi": ("si",),
    "chi": ("ti",),
    "tsu": ("tu",),
    "fu": ("hu",),
    "ji": ("zi", "di"),
    "zu": ("du",),
    "wo": ("o",),
    "n": ("nn",),
    "sha": ("sya",), "shu": ("syu",), "sho": ("syo",),
    "cha": ("tya", "cya"), "chu": ("tyu", "cyu"), "cho": ("tyo", "cyo"),
    "ja": ("jya", "zya", "dya"), "ju": ("jyu", "zyu", "dyu"), "jo": ("jyo", "zyo", "dyo"),
}


# Shown in parentheses when a miss reveals the answer. Only WO qualifies: its
# alternate is a different READING (the particle is pronounced "o", which is
# what DJT Kana teaches), while the other 16 VARIANTS are alternate TYPINGS of
# the same sound - si/ti/tu/hu/nn and friends. Printing those on every miss
# would turn a reading drill into a spelling lesson.
REVEAL_EXTRA = {"wo": "o"}


def answers(canonical):
    """All accepted romaji spellings for a canonical reading."""
    return (canonical,) + VARIANTS.get(canonical, ())


def reveal(canonical):
    """What the drill prints after a miss: "kya", or "wo (o)"."""
    extra = REVEAL_EXTRA.get(canonical)
    return "%s (%s)" % (canonical, extra) if extra else canonical


# --- groups -----------------------------------------------------------------
# ROWS already IS the group structure (a row per consonant), so per-group
# toggles need no new table -- only a stable ORDER, because a group's position
# in that order is its bit index in nvm. Deriving the order from ROWS keeps the
# two impossible to disagree; reordering ROWS would silently remap saved masks,
# which is what GROUP_COUNTS in preflight guards against.
CATEGORIES = ("H", "K", "HC", "KC")


def groups(category):
    """Row ids for a category, in bit order. H/K have 16, HC/KC have 12."""
    return [row for cat, row, _e in ROWS if cat == category]


def group_entries(category, row_id):
    for cat, row, entries in ROWS:
        if cat == category and row == row_id:
            return entries
    return []


def group_label(category, row_id):
    """The kana that stands for a group in the grid -- its first entry. A
    romaji row id like 'ky' means nothing at a glance; the kana does."""
    entries = group_entries(category, row_id)
    return entries[0][0] if entries else "?"


def group_romaji(row_id):
    """What prints in the title gap for the highlighted cell: 'h-', 'ky-'."""
    return row_id + "-"


def full_mask(category):
    """Every group of a category enabled -- the default, and what 'All on'
    writes. Also the value that reproduces the old all-or-nothing behaviour."""
    return (1 << len(groups(category))) - 1


def mask_count(category, mask):
    """(enabled, total) for a category's mask, for the 'Hiragana 16/16' row."""
    total = len(groups(category))
    return sum(1 for i in range(total) if mask & (1 << i)), total


_GROUP_OF = None


def group_of(kana_text):
    """(category, row_id) a prompt belongs to, or None.

    Built lazily and once: the stats screen needs this per answer, and walking
    ROWS every time would be 56 rows x 5 entries per keystroke.
    """
    global _GROUP_OF
    if _GROUP_OF is None:
        _GROUP_OF = {}
        for cat, row, entries in ROWS:
            for text, _romaji in entries:
                # A kana can appear in two categories (it cannot today, but
                # nothing enforces that), so first writer wins and the deck
                # order decides -- deterministic either way.
                _GROUP_OF.setdefault(text, (cat, row))
    return _GROUP_OF.get(kana_text)


def build_deck(categories, masks=None):
    """[(kana, canonical), ...] for the enabled categories.

    masks maps a category id to a bitmask over groups(cat); a category absent
    from masks (or masks=None) means all of its groups, which is exactly the
    behaviour before per-group toggles existed.
    """
    deck = []
    for cat, row, entries in ROWS:
        if cat not in categories:
            continue
        if masks is not None and cat in masks:
            if not masks[cat] & (1 << groups(cat).index(row)):
                continue
        deck.extend(entries)
    return deck
