r3vert/KanaType/(commit log)

2026-08-03 Main Version
    [KanaType.kicad_pcb, KanaType.kicad_sch, KanaType.step]
2026-08-28 Hardware: E9 column pull-downs, OLED support parts, WAKE/RESET
    - R1-R8: 8.2k pull-downs on COL1-COL8. Neutralize the RP2350-E9 erratum
    (whose internal pull-downs are unreliable) and hold the columns low when
    no key is pressed. This commits the board to ACTIVE-HIGH scanning
    permanently: columns_to_anodes=False everywhere, non-negotiable.
    - R9, R10: 8.2k I2C pull-ups on SDA/SCL, so the bus is self-sufficient
    regardless of what an attached module provides.
    - R11: 1k series for WAKE1, capping fault current at 3.3 mA when the key
    drives COL8 against its 8.2k pull-down.
    - C1: 10 uF bulk cap across 3.3 V near J1, as the OLED transient reservoir.
    - RESET1 / WAKE1 tactile switches.
    Also co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
    [KanaType.kicad_pcb, KanaType.kicad_sch]
2026-08-28 Firmware: CircuitPython app platform, practice drill, keyboard + macros
    The whole Firmware/ tree, none of which was tracked before.
    Platform (src/kanatype/): launcher with lazy per-boot app import, shared UI
    widgets, matrix + serial input drivers behind one logical key-code contract,
    nvm-backed settings, 128x64 geometry.
    Apps: Practice (DJT-style kana drill, 214-item deck, four prompt fonts),
    Keyboard (KMK), Clock (view/set RTC), Sleep (manual deep sleep), plus stubs
    for Quick note and Vault.
    Keyboard app + macro system:
    - M1..M4 are user-assignable, with a second layer (M5..M8, number row ->
    F1..F10, Q/W -> F11/F12) toggled by the key right of the spacebar
    - an assignment is (modifier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
2026-08-28 Add printable bottom case
    3MF for the enclosure's bottom half.
    [Bottom Case.3mf]
2026-08-28 Carry the clock across deep sleep, since the RTC does not
    Tested on hardware 2026-08-28: set the clock, Sleep, WAKE, and the RTC comes
    back unset. This is structural. CircuitPython's deep sleep "shuts down power
    to nearly all of the microcontroller including the CPU and RAM" and restarts
    code.py from the top, and the Feather RP2040 has no battery-backed RTC domain
    -- the LiPo holds the rail up but the RTC's clock stops and the chip resets on
    wake. No firmware change recovers the real time. Resolves PLAN.md open item #3,
    negatively.
    Fallback:
    - sleepmode.py stamps the wall clock into nvm before sleeping
    - code.py restores it on boot, but ONLY when the RTC looks unset: on USB,
    CircuitPython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
    [clock.py, power.py, settings.py, sleepmode.py]
2026-08-28 Keyboard app and macro system confirmed on hardware
    BRINGUP task 4 passes in full: typing, MENU tap/hold, the setup overlay
    swallowing keys without dropping USB, the key picker, the layer toggle,
    profiles and nvm persistence. That was the largest untested surface in the
    project. Kept as a regression checklist rather than deleted.
    Next is task 5: the drill has not run on hardware since the 2026-08 reflow.
2026-08-29 Practice: correction mode, miss reveal, and a full-width home screen
    Closes this stage of the UI work. Everything here is deployed and confirmed on
    hardware except where noted.
    Home screen (launcher):
    - apps down the left in the small font, clock and power state on the right,
    split by a rule. All five apps visible where four used to be.
    - Clock left the app list; the clock panel is a focus target one past the last
    app and Enter there opens it, rather than having two doors into one room.
    - "~" beside the time marks a clock restored after a deep sleep. It is drawn
    as its own label in the left margin, offset +4 to sit on the digits' centre
    line, so the time does not shift when the flag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
    [clock.py, clockstore.py, config.py, drill.py, kana.py, layout.py, power.py]
2026-08-29 Record the measured drill RAM cost
    Two readings off the device close PLAN open item #2, open since M3:
    hiragana only 71 glyphs 48 320 B free
    all four 148 glyphs 24 304 B free
    which gives 312 bytes per 40px glyph, measured rather than estimated. The
    ~320 B the preload was designed around was right to within 3%.
    Consequences recorded in PLAN.md: 24 KB is the floor this design leaves, there
    is no room for a second 40px font resident at once, and a kanji font at this
    size is out of the question (312 B x 2000+ glyphs) - which constrains the M2
    vault reader to a much smaller size or to PCF's load-on-demand.
    BRINGUP task 5 is complete apart from sighting "wo (o)", which just nee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
2026-08-29 Scrub local identifiers before the repo goes public
    - KanaType.kicad_pcb embedded an absolute Windows path in 61 3D-model
    references, publishing the account name. Replaced with ${KIPRJMOD}, a KiCad
    path variable relative to the project. The diff is 61 changed lines, all of
    them (model ...) entries: 3D models are cosmetic, so DRC, the netlist and
    the fab output are untouched.
    - Firmware/OLD/boot_out.txt carried the board's hardware UID. Dropped that
    line and kept the CircuitPython version and board ID, which settings.toml
    refers to.
    - fp-info-cache untracked and gitignored: 4 MB that KiCad regenerates from the
    installed libraries and no clone needs.
    STILL OUTSTANDING before thi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
    [KanaType.kicad_pcb]
2026-08-29 Refresh the bring-up status for a clean handoff
    The STATUS block still said "nothing is committed to git yet" and pointed at
    task 5, both untrue since the repo went public. It now records what is
    confirmed on hardware (tasks 1-5 and 8, the RAM measurement) and what is not:
    the Clock's approx flag, the deep-sleep clock carry-over that was built AFTER
    the RTC was proven not to survive and has never itself run, sleep/wake, and
    the battery pass. NEXT ACTION moved to task 6.
2026-08-29 Flag the clock approximate when it is restored, not when it is stamped
    Hardware testing reported that "approx (slept)" never appeared across
    several resets and sleeps. Accuracy was being decided when the nvm stamp
    was written, which was wrong in both directions:
    - A plain RESET (or a flat battery) also boots with a dead RTC, so the
    restore ran, but the stamp still claimed exact. The device presented an
    arbitrarily stale clock as the truth, with no warning.
    - A USB sleep is a fake deep sleep: the RTC keeps ticking and the time on
    the far side is genuinely exact, yet it would have been flagged.
    restore_time_after_sleep() now sets the flag, since a deep sleep, a reset
    and a dead battery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
    [clockstore.py, power.py]
2026-08-29 Mock up the drill reflow and park it as backlog item 3
    Drops the H/K/HC/KC column (that readout moves to the stats screen),
    puts the prompt at the bottom shifted left, and moves the correct-reading
    reveal to the top in a larger font. Not built: geometry stays out of
    layout.py like the other two parked features.
    Two findings the mockup paid for:
    - prompt y has to be measured against all 148 kana. The first 48px draft
    looked right on kya and clipped small-yu (U+3085) off row 63. Correct
    values are y=38 at 48px, y=40 at 44px, y=42 at 40px.
    - the prompt size is a RAM decision. At the measured 312 B per 40px glyph
    against a ~70.5 KB pool, 48px leaves ~4 KB with all four scripts
    enabled,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
2026-08-29 Target 48px for the drill reflow, making PCF a prerequisite
    Assumes PCF has landed by the time the reflow is built, so the prompt
    gets the biggest font rather than the biggest one that fits as a
    resident BDF. Logged from both ends: the backlog item names PCF as a
    hard prerequisite, and the PCF follow-up now says it is a requirement
    rather than only a boot-speed win, so it does not get deprioritised on
    its own.
    All three sizes stay on record with their measured prompt_y (40px y=42,
    44px y=40, 48px y=38) and their BDF RAM cost, and the mockup renders all
    three. The pick is deferred to build time: 44px is the fallback that
    still fits every deck without PCF, and the reflow alone at 40px costs
    n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
2026-08-30 Confirm the clock accuracy fix on hardware
    Task 6 passes and the RESET case behaves: set the clock, press RESET,
    and Clock comes back with the frozen time flagged approx (slept). That
    was the defect worth catching, since the old code presented an
    arbitrarily stale clock as exact.
    Task 8's four sleep-path boxes still need an unplugged run with a
    battery, so the marker moves there rather than to task 9.
2026-08-30 Ship PCF fonts instead of BDF
    The BDF loader keeps no glyph index and rescans the whole file for any
    uncached code point; the PCF loader in the same library seeks straight to
    each glyph. A preload pass already bought most of the boot win, but PCF
    is what takes the remaining ~595 ms of scanning, and it is a hard
    prerequisite for the 48px drill prompt, which cannot be resident as a
    BDF once every script is enabled.
    tools/bdf2pcf.py is written rather than installed: no pure-Python
    converter exists and the X.org bdftopcf is a C tool. It emits only the
    four tables the Adafruit reader reads, and deliberately skips PROPERTIES
    because the library's own accessor for it would raise.
    Two things that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
    [layout.py]
2026-08-30 Load drill prompt glyphs on demand, and correct the PCF RAM claim
    The drill preloaded its whole prompt font because the BDF loader rescanned
    the file for every uncached glyph, so paying for the entire deck up front
    behind a "Loading..." splash was cheaper than paying ~3.1 s per first-seen
    kana. PCF seeks straight to each glyph, so both the preload and the splash
    are gone.
    Correcting something I wrote yesterday: PCF does NOT remove the RAM
    ceiling for a 48px prompt. adafruit_bitmap_font's GlyphCache never evicts
    (checked in the library source), and a drill is exactly the thing that
    eventually displays every kana in the deck, so a long session converges on
    the same resident total that preload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
    [drill.py, ui.py]
2026-08-30 Record the PCF hardware confirmation
    Kana render correctly and Practice enters instantly with no splash. The
    rendering is the part that mattered: the device uses bitmaptools.readinto
    with element_size=4 rather than the pure-Python bitmap path the desktop
    verifier replicates, and a wrong bit order would have scrambled every
    glyph rather than failing quietly.
    Two numbers are still uncaptured, both serial-only, and BRINGUP 9b holds
    them: boot's glyphs step (595 ms under BDF) and the drill's free-RAM
    figure. The second one is worth watching drift downward, since that drift
    is the evidence for the eviction work a 48px prompt needs.
2026-08-30 Record the PCF boot measurement and trace the drill's RAM curve
    glyphs 595 ms -> 128 ms, a 4.6x cut, and the menu build 827 -> 563 ms.
    Only glyphs compares directly: the home screen was redesigned between the
    two measurements, so the icons step folded away and labels now builds an
    app list, a clock and a power icon and calls open_clock(), which is why it
    rose 95 -> 245 ms while the total still fell. font rose 64 -> 90 ms
    because PCF reads three table headers at init where BDF parsed one.
    The drill's free-RAM figure needed an instrument rather than a reading.
    Glyphs now load as they are first shown and the cache never evicts, so the
    number that matters is the CURVE, and Screen() printed once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
    [drill.py]
2026-08-30 Measure the glyph cache directly instead of inferring it from free heap
    The first RAM trace was invalid: it called gc.mem_free() without
    gc.collect() first, so it reported free heap including garbage that had
    not been collected. Over 60 answers it printed 46/57/59/52/55/50 KB, a
    sawtooth that rises as often as it falls - the allocator, not the glyph
    cache. Screen.__init__ had always collected before its print, and the new
    trace did not.
    It now collects first, and prints the resident glyph COUNT alongside the
    deck total, which is the direct measurement and needs no inference from a
    noisy free-heap figure.
2026-08-30 Per-group practice toggles: data, persistence and grid geometry
    ROWS already was the group structure, so this needed an order (a group's
    position is its bit index in nvm), a mask-aware build_deck, and the grid.
    build_deck with every bit set is identical to the old all-or-nothing
    behaviour, and a category absent from the masks means all of its groups.
    Masks persist in 9 bytes at [113:122] under their own marker, the same
    trick clockstore used, so adding them resets nobody's macros, practice
    settings or clock. A corrupt region or an all-zero mask falls back to the
    full mask rather than handing the drill an empty deck. Reset to defaults
    clears them too - a reset that left half a category off w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
    [kana.py, layout.py, settings.py]
2026-08-30 Per-group toggles: the grid screen and its config wiring
    RIGHT on a category row opens its grid; Enter on that row still toggles
    the whole category, so the common case stays one keypress.
    RIGHT rather than the held Enter the mockup imagined, because a hold
    cannot be timed at all from an app: MatrixInput.poll() emits presses and
    drops releases. The keyboard app manages a hold only because it hooks
    KMK's own scanner instead of this driver. Inside the grid BACKSPACE goes
    back, since LEFT has to stay free to move the cursor or half the cells are
    unreachable.
    Fills and the cursor underline live in one displayio.Bitmap behind the
    labels rather than in per-label background_color: that background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
2026-08-30 Practice stats screen: per-category and per-group accuracy
    Opened from the drill with LAYER, the key right of the spacebar. NOT the
    MENU key the mockup imagined: MENU already maps to app code "exit", which
    is how the drill returns to config and is confirmed on hardware. LAYER is
    the only app code the practice app was not already using.
    Counting is correct-first-try over answered, the same fraction the drill
    screen shows, so the two cannot disagree. A category with nothing answered
    shows "-" rather than 0%: untried and failed mean very different things
    when you are picking what to drill.
    The per-category view reuses the toggle grid's COLUMNS so a kana sits in
    the same place on both screens,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
    [drill.py, kana.py, layout.py, stats.py]
2026-08-31 Stats: per-symbol drill-down, and no flash between screens
    The flash was structural. Each screen restored the drill in its own
    finally, so leaving the overview repainted the drill for a frame before
    the next screen swapped in. Screens now only swap themselves in and run()
    puts the caller's screen back once, at the end.
    Counting moves from per-group to per-SYMBOL, with group and category
    figures summed upward rather than counted separately - one source of
    truth, so the three levels cannot drift apart. preflight checks they add
    up at every level.
    The new third level answers the question the group bar could not: k- being
    weak does not tell you it is ki you keep missing. Enter on a group opens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
    [drill.py, layout.py, stats.py]
